Andy61994/SLAM_Bachelorarbeit_Pruefer/DataSheets/Pinout_Arduino_Mega.PNG

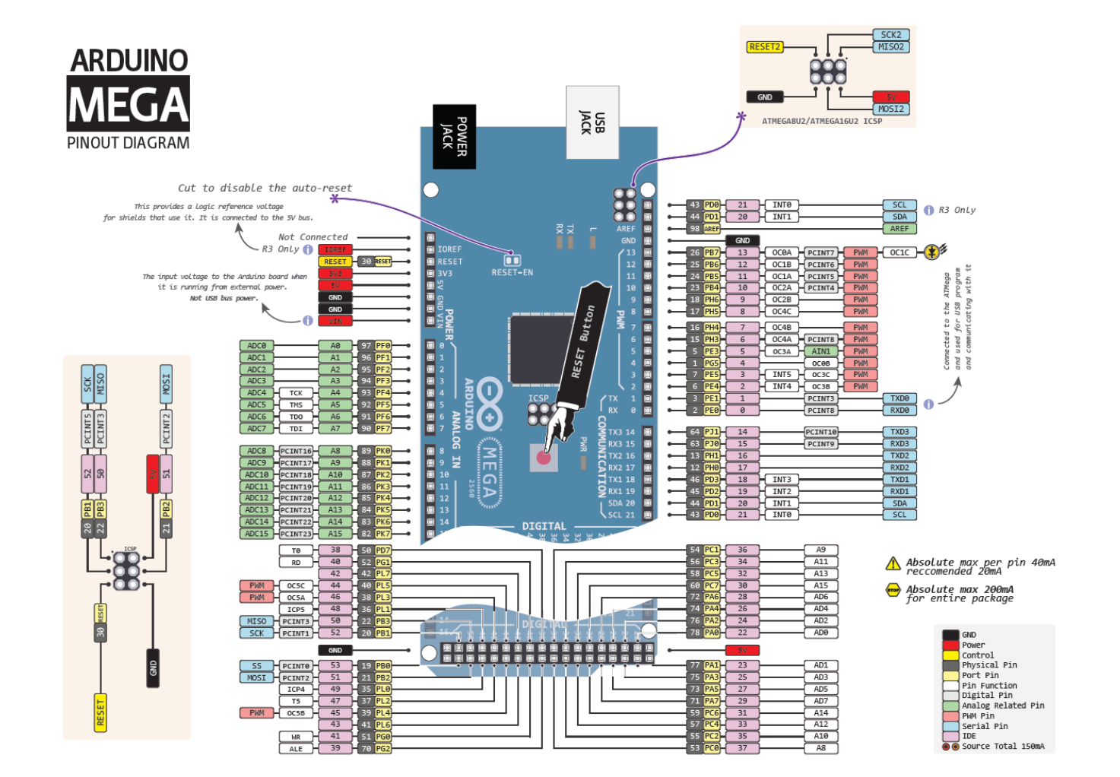
DataSheets/Pinout_Arduino_Mega.PNG
