Andy61994/SLAM_Bachelorarbeit_Pruefer/Digitaler_Anhang/CAD/IMG_20210322_150707.jpg

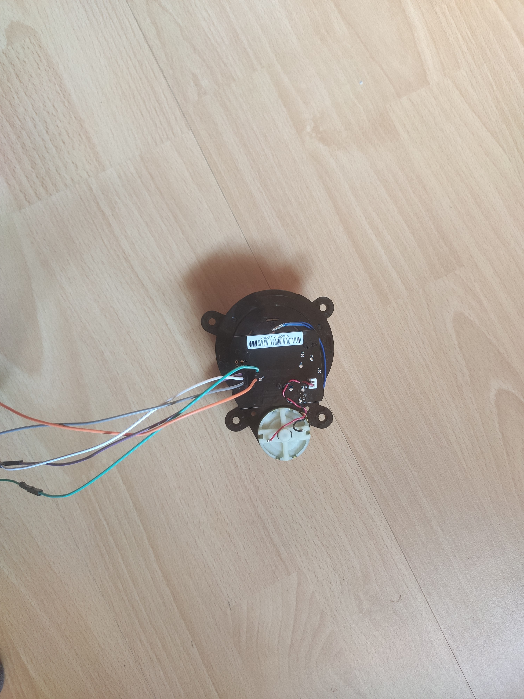
Digitaler_Anhang/CAD/IMG_20210322_150707.jpg
