Andy61994/SLAM_Bachelorarbeit_Pruefer/Digitaler_Anhang/Videos/mapping_filmed-YoutubeVideo.txt

https://www.youtube.com/watch?v=3mpuv1_3xI8&t=168s
