Andy61994/SLAM_Bachelorarbeit_Pruefer/Digitaler_Anhang/Bilder/D_A1_rosgraph_topics_and_nodes.png

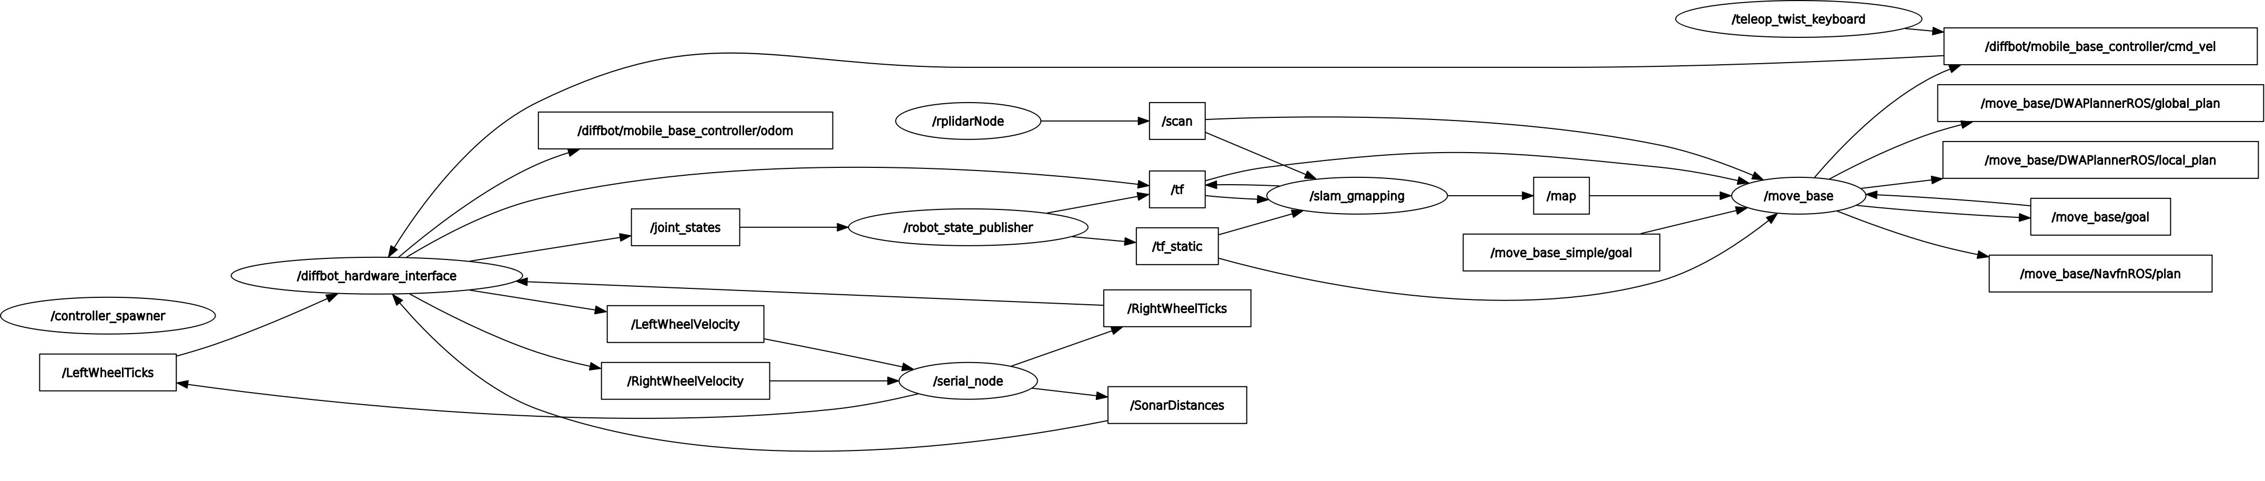
Digitaler_Anhang/Bilder/D_A1_rosgraph_topics_and_nodes.png
