Andy61994/SLAM_Bachelorarbeit_Pruefer/Digitaler_Anhang/Bilder/D_A3_tf_tree.png

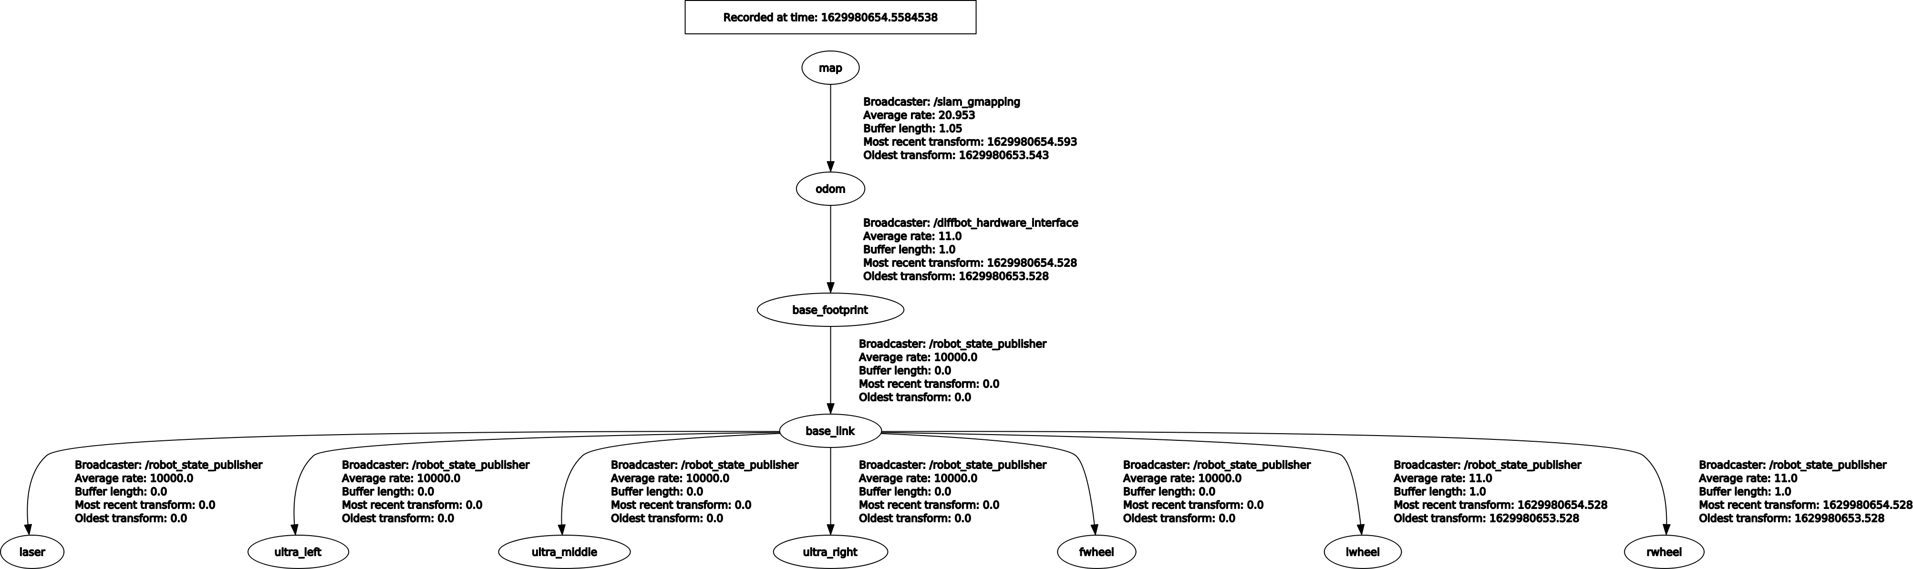
Digitaler_Anhang/Bilder/D_A3_tf_tree.png
