Andy61994/SLAM_Bachelorarbeit_Pruefer/Digitaler_Anhang/CAD/00_RobotAssembly.stl

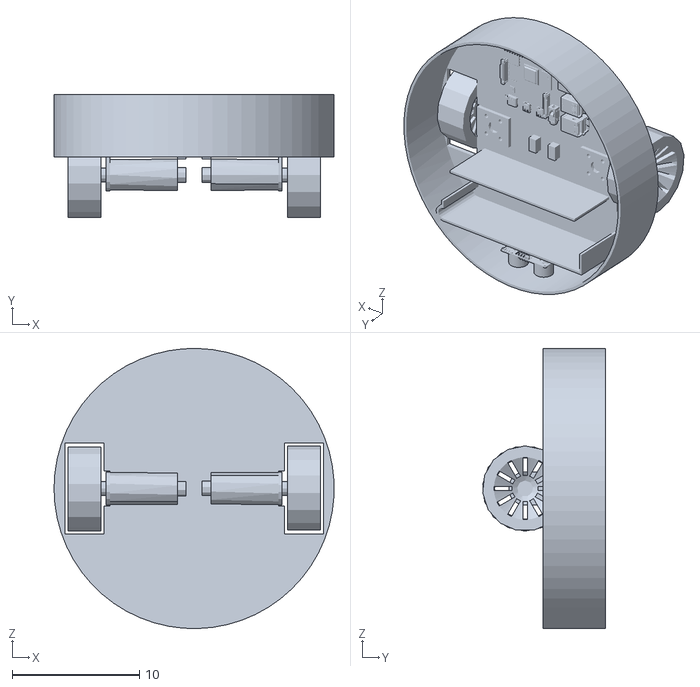
[picture p32: CAD file, 2021-09-02]
Digitaler_Anhang/CAD/00_RobotAssembly.stl
22.0 x 9.63 x 22.0
