Andy61994/SLAM_Bachelorarbeit_Pruefer/Digitaler_Anhang/CAD/ArduinoMega/Arduino Mega.STEP

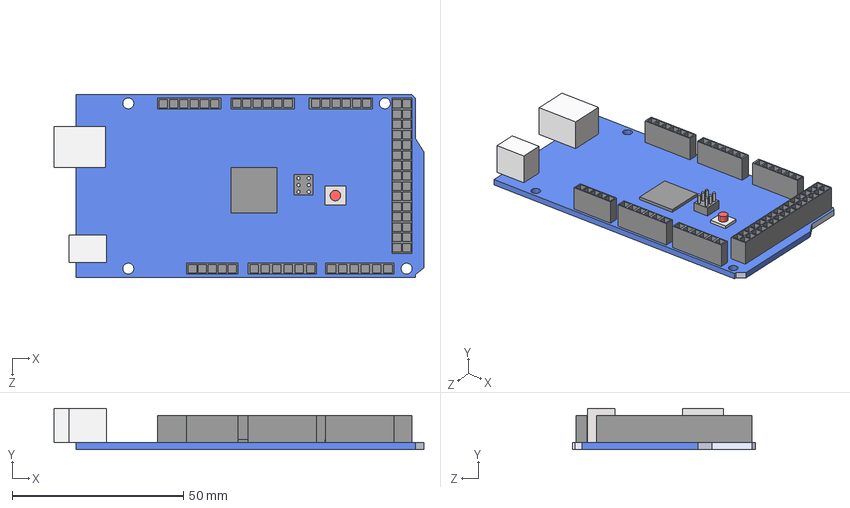
[picture p33: CAD file, 2021-09-02]
Digitaler_Anhang/CAD/ArduinoMega/Arduino Mega.STEP
108.1 x 12.0 x 53.3 mm
