Andy61994/SLAM_Bachelorarbeit_Pruefer/Digitaler_Anhang/CAD/Bauteil125.stl

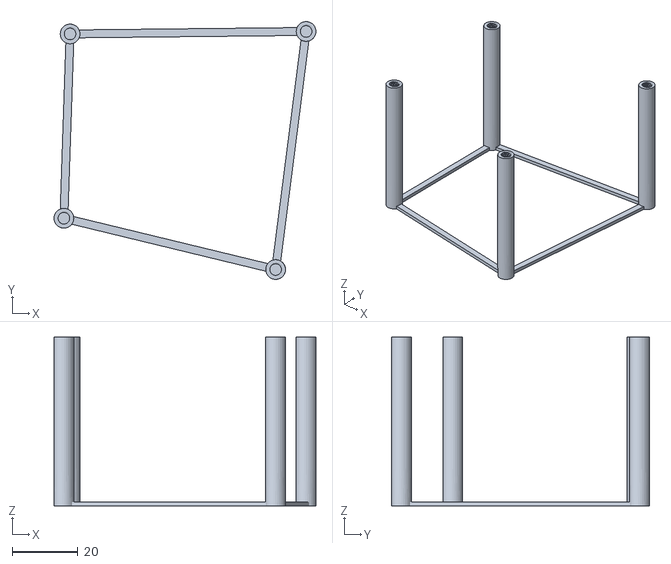
[picture p34: CAD file, 2021-09-02]
Digitaler_Anhang/CAD/Bauteil125.stl
79.5 x 78.2 x 51.2
