Andy61994/SLAM_Bachelorarbeit_Pruefer/Digitaler_Anhang/CAD/test/BauteilM_3_5.stl

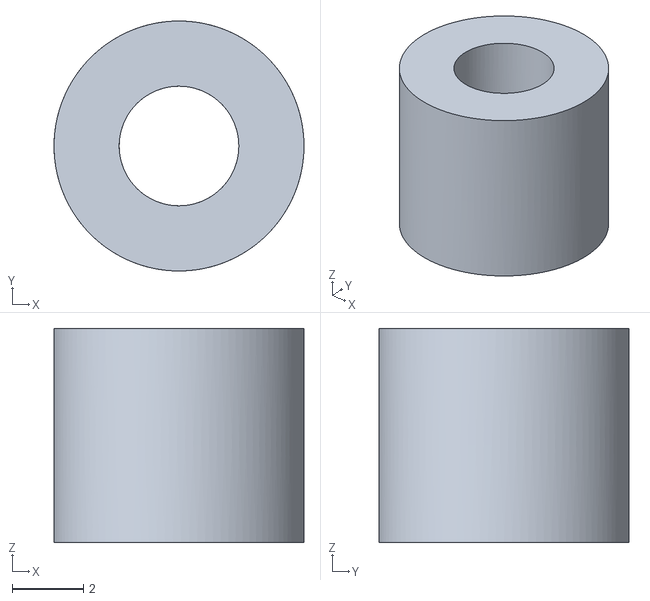
[picture p35: CAD file, 2021-09-02]
Digitaler_Anhang/CAD/test/BauteilM_3_5.stl
7.00 x 7.00 x 6.00
