Andy61994/SLAM_Bachelorarbeit_Pruefer/Digitaler_Anhang/CAD/08_HolderSR04.stl

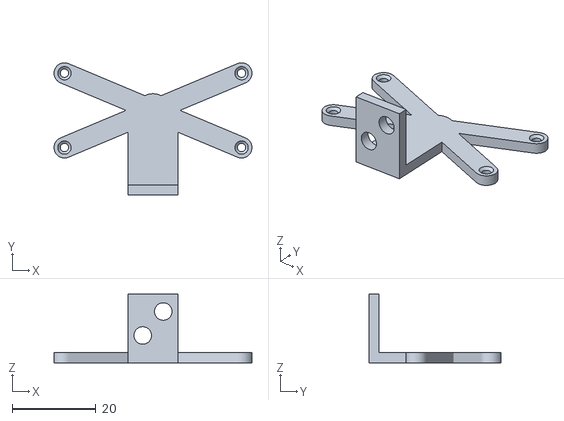
[picture p36: CAD file, 2021-09-02]
Digitaler_Anhang/CAD/08_HolderSR04.stl
47.4 x 31.7 x 16.4
