Andy61994/SLAM_Bachelorarbeit_Pruefer/Digitaler_Anhang/CAD/ArduinoMega/arduinoMegaSimplified.STEP

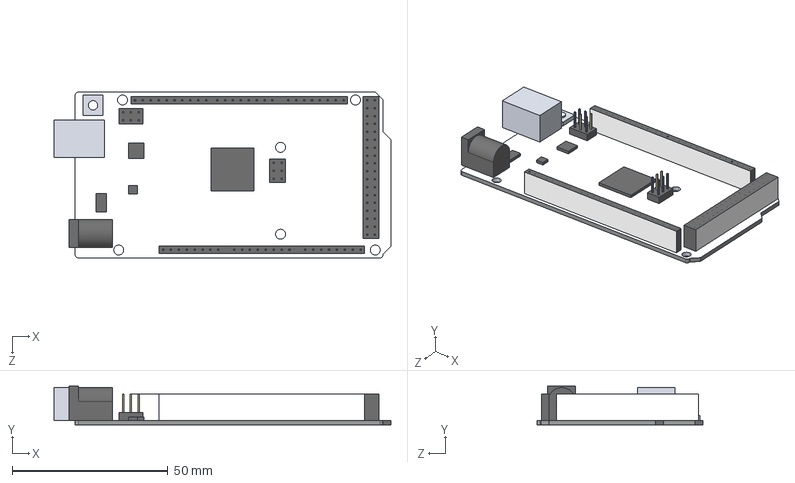
[picture p37: CAD file, 2021-09-02]
Digitaler_Anhang/CAD/ArduinoMega/arduinoMegaSimplified.STEP
108.3 x 12.5 x 53.3 mm
