Andy61994/SLAM_Bachelorarbeit_Pruefer/Digitaler_Anhang/CAD/test/Bauteil1.stl

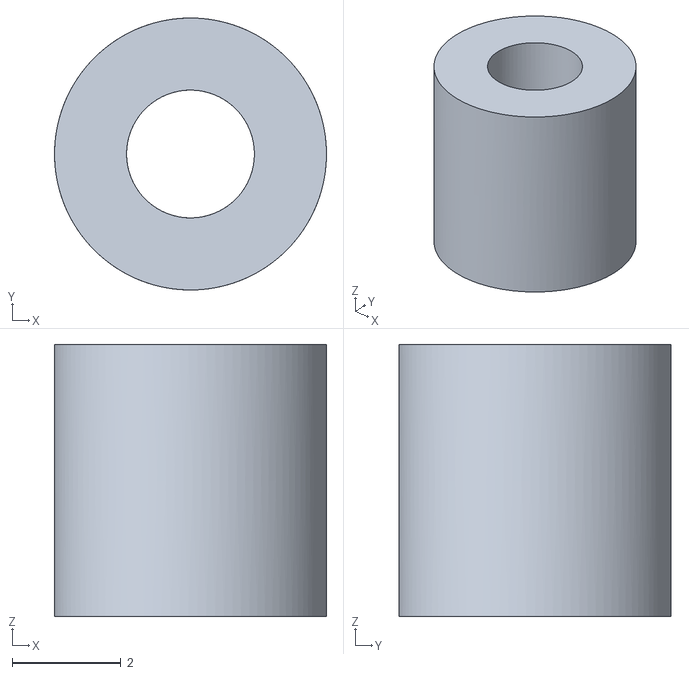
[picture p38: CAD file, 2021-09-02]
Digitaler_Anhang/CAD/test/Bauteil1.stl
5.00 x 5.00 x 5.00
