Andy61994/SLAM_Bachelorarbeit_Pruefer/Digitaler_Anhang/CAD/13_Motor_Fixation_Thread_Mount.stl

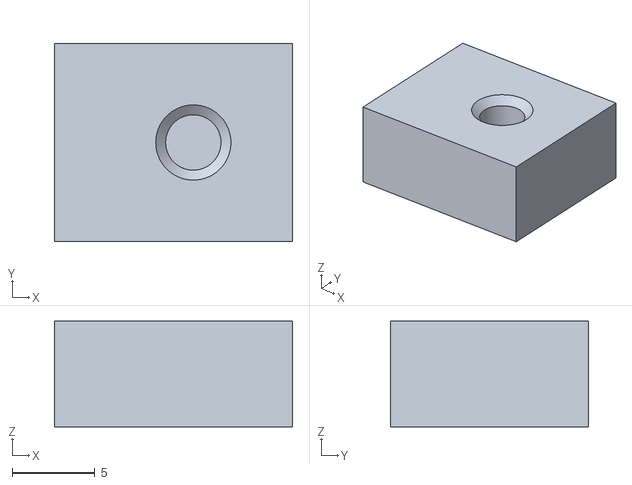
[picture p39: CAD file, 2021-09-02]
Digitaler_Anhang/CAD/13_Motor_Fixation_Thread_Mount.stl
14.4 x 12.0 x 6.40
