Andy61994/SLAM_Bachelorarbeit_Pruefer/Digitaler_Anhang/CAD/ArduinoMega/ArduinoMega_STEP_AP203.STEP

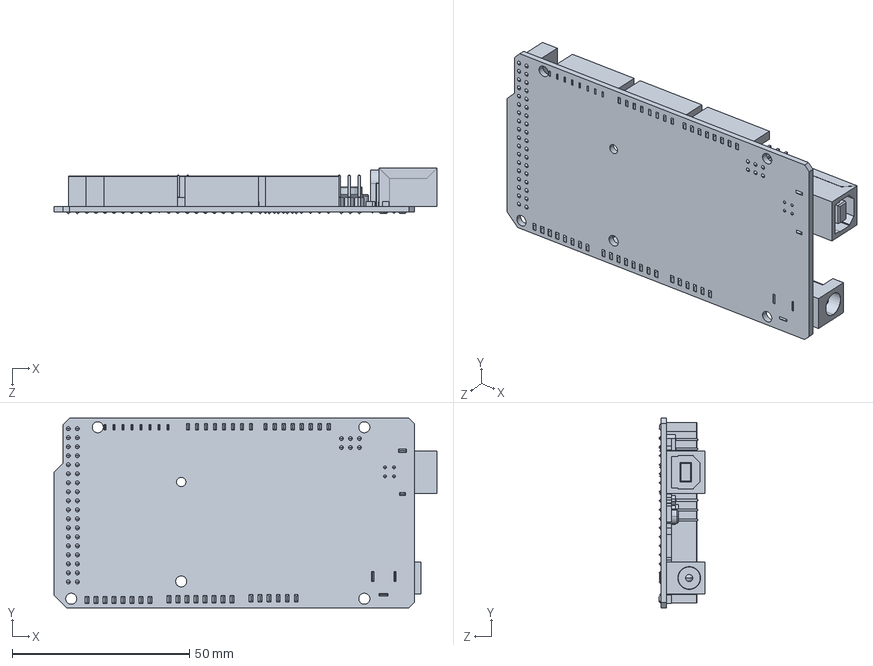
[picture p40: CAD file, 2021-09-02]
Digitaler_Anhang/CAD/ArduinoMega/ArduinoMega_STEP_AP203.STEP
107.9 x 53.4 x 13.0 mm
