Andy61994/SLAM_Bachelorarbeit_Pruefer/Digitaler_Anhang/CAD/11_Arduino_Holder.stl

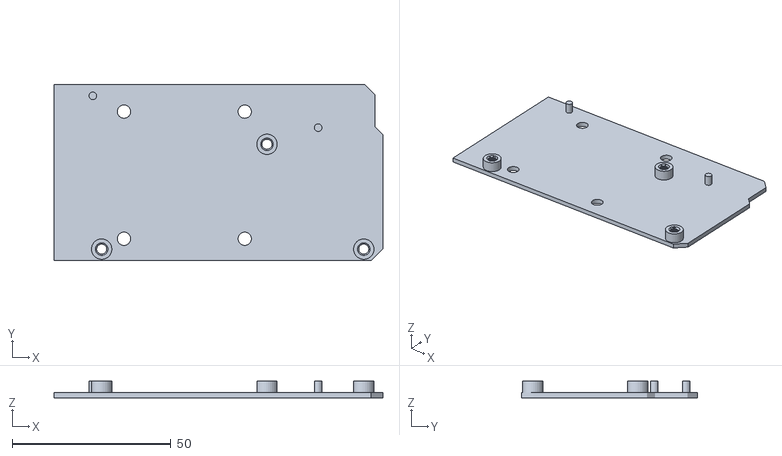
[picture p41: CAD file, 2021-09-02]
Digitaler_Anhang/CAD/11_Arduino_Holder.stl
103.5 x 55.3 x 5.20
