Andy61994/SLAM_Bachelorarbeit_Pruefer/Digitaler_Anhang/CAD/12_Motor_Fixation.stl

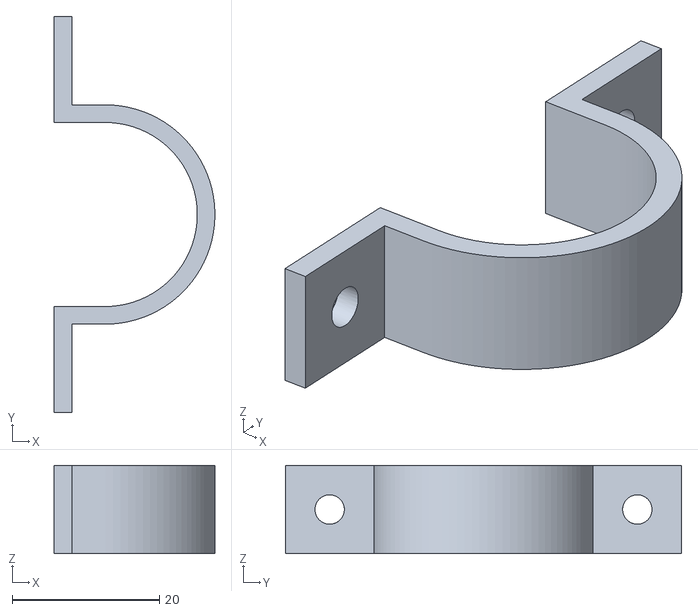
[picture p42: CAD file, 2021-09-02]
Digitaler_Anhang/CAD/12_Motor_Fixation.stl
21.8 x 53.8 x 12.0
