Andy61994/SLAM_Bachelorarbeit_Pruefer/Digitaler_Anhang/CAD/06_RPLidar_Raspi_Adabter.stl

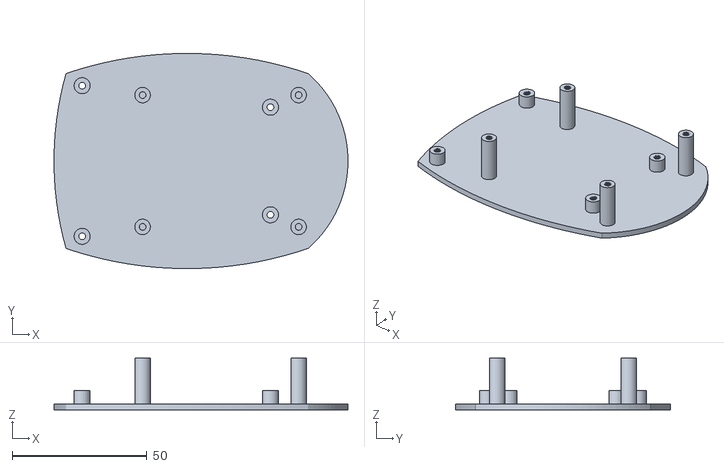
[picture p43: CAD file, 2021-09-02]
Digitaler_Anhang/CAD/06_RPLidar_Raspi_Adabter.stl
109.3 x 80.0 x 19.2
