Andy61994/SLAM_Bachelorarbeit_Pruefer/Digitaler_Anhang/CAD/10_Holder_Step_Down.stl

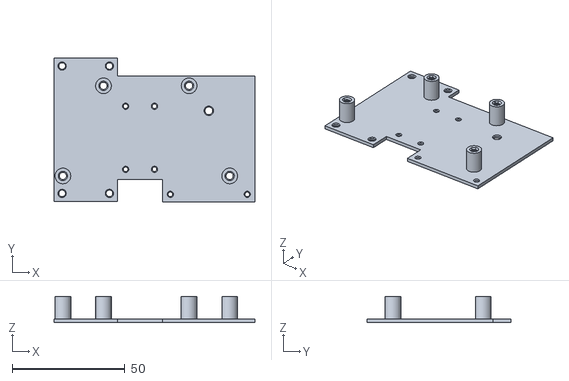
[picture p44: CAD file, 2021-09-02]
Digitaler_Anhang/CAD/10_Holder_Step_Down.stl
89.2 x 63.9 x 11.6
