Andy61994/SLAM_Bachelorarbeit_Pruefer/Digitaler_Anhang/CAD/03_MotorHolder.stl

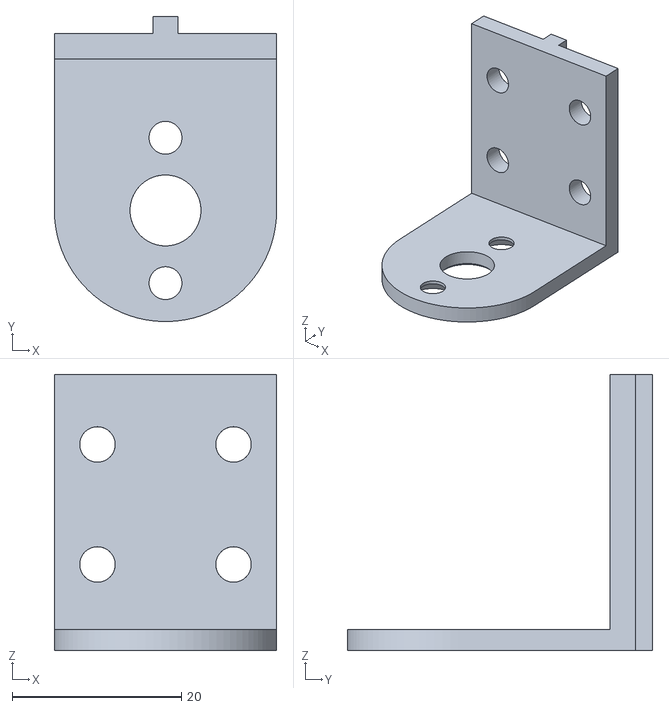
[picture p45: CAD file, 2021-09-02]
Digitaler_Anhang/CAD/03_MotorHolder.stl
26.3 x 36.1 x 32.7
