Andy61994/SLAM_Bachelorarbeit_Pruefer/Digitaler_Anhang/CAD/07_HolderSR04.stl

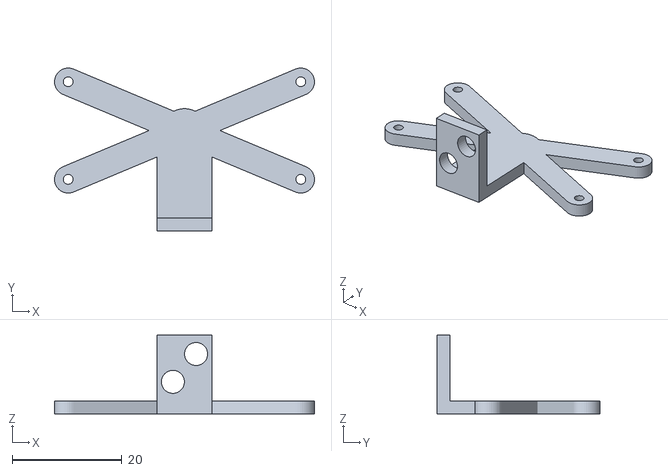
[picture p46: CAD file, 2021-09-02]
Digitaler_Anhang/CAD/07_HolderSR04.stl
47.4 x 29.7 x 14.4
