Andy61994/SLAM_Bachelorarbeit_Pruefer/Digitaler_Anhang/CAD/07_CaseTop.stl

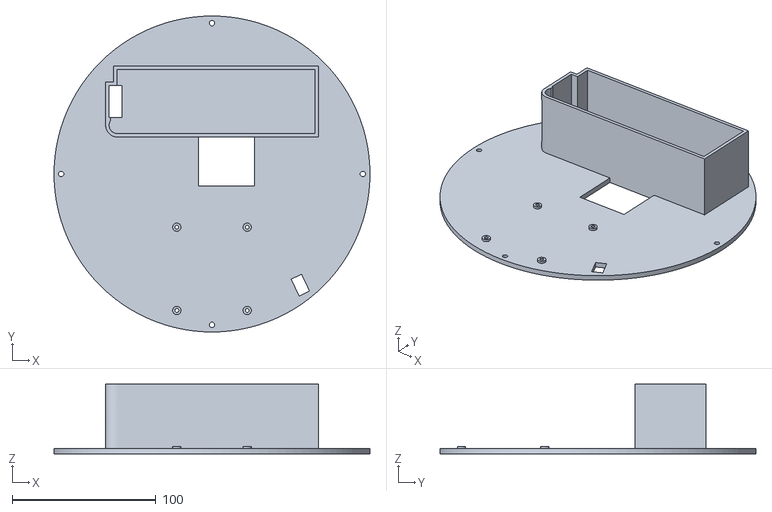
[picture p47: CAD file, 2021-09-02]
Digitaler_Anhang/CAD/07_CaseTop.stl
220.0 x 220.0 x 48.6
