Andy61994/SLAM_Bachelorarbeit_Pruefer/Digitaler_Anhang/CAD/06_RPLidar_Raspi_Adabter_NoThread.stl

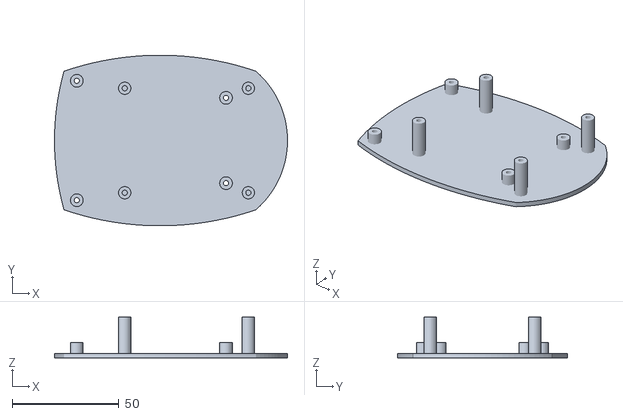
[picture p48: CAD file, 2021-09-02]
Digitaler_Anhang/CAD/06_RPLidar_Raspi_Adabter_NoThread.stl
109.3 x 80.0 x 19.2
