Andy61994/SLAM_Bachelorarbeit_Pruefer/Digitaler_Anhang/CAD/09_Cstor_Distance_Plate.stl

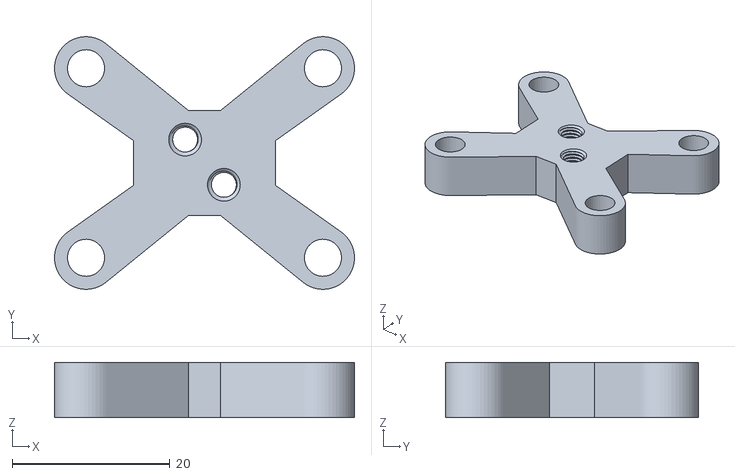
[picture p49: CAD file, 2021-09-02]
Digitaler_Anhang/CAD/09_Cstor_Distance_Plate.stl
38.0 x 32.0 x 7.00
