Andy61994/SLAM_Bachelorarbeit_Pruefer/(list of files, cad)

Other CAD files:
Digitaler_Anhang/CAD/test/Bauteil1_2.45.stl
Digitaler_Anhang/CAD/00_Mastersketch.ipt
Digitaler_Anhang/CAD/01_CaseBottom.ipt
Digitaler_Anhang/CAD/02_Motor.ipt
Digitaler_Anhang/CAD/03_MotorHolder.ipt
Digitaler_Anhang/CAD/04_Wheel.ipt
Digitaler_Anhang/CAD/05_WheelJoint.ipt
Digitaler_Anhang/CAD/06_RPLidar_Raspi_Adabter.ipt
Digitaler_Anhang/CAD/06_RPLidar_Raspi_Adabter_NoThread.ipt
Digitaler_Anhang/CAD/07_CaseTop.ipt
Digitaler_Anhang/CAD/08_HolderSR04.ipt
Digitaler_Anhang/CAD/09_Cstor_Distance_Plate.ipt
Digitaler_Anhang/CAD/10_Holder_Step_Down.ipt
Digitaler_Anhang/CAD/11_Arduino_Holder.ipt
Digitaler_Anhang/CAD/12_Motor_Fixation.ipt
Digitaler_Anhang/CAD/13_Motor_Fixation_Thread_Mount.ipt
Digitaler_Anhang/CAD/ArduinoMega/OldVersions/arduinoMegaSimplified.0001.ipt
Digitaler_Anhang/CAD/ArduinoMega/arduinoMegaSimplified.ipt
Digitaler_Anhang/CAD/Bauteil125.ipt
Digitaler_Anhang/CAD/CastorWheel/Castor_Wheel.ipt
Digitaler_Anhang/CAD/CastorWheel/OldVersions/Castor_Wheel.0001.ipt
Digitaler_Anhang/CAD/HC-SR04_Ultraronic/06_RPLidar_Raspi_Adabter_NoThread.ipt
Digitaler_Anhang/CAD/HC-SR04_Ultraronic/HC-SR04.ipt
Digitaler_Anhang/CAD/HC-SR04_Ultraronic/OldVersions/HC-SR04.0001.ipt
Digitaler_Anhang/CAD/HC-SR04_Ultraronic/OldVersions/HC-SR04.0002.ipt
Digitaler_Anhang/CAD/HC-SR04_Ultraronic/slam-head-rpi3-Powerbank-holder.ipt
Digitaler_Anhang/CAD/HC-SR04_Ultraronic/slam-head-rpi3-simple-Simple-Chassis_Full.ipt
Digitaler_Anhang/CAD/OldVersions/00_Mastersketch.0020.ipt
Digitaler_Anhang/CAD/OldVersions/01_CaseBottom.0029.ipt
Digitaler_Anhang/CAD/OldVersions/02_Motor.0005.ipt
Digitaler_Anhang/CAD/OldVersions/03_MotorHolder.0011.ipt
Digitaler_Anhang/CAD/OldVersions/04_Wheel.0005.ipt
Digitaler_Anhang/CAD/OldVersions/05_WheelJoint.0015.ipt
Digitaler_Anhang/CAD/OldVersions/06_RPLidar_Raspi_Adabter_NoThread.0001.ipt
Digitaler_Anhang/CAD/OldVersions/07_CaseTop.0009.ipt
Digitaler_Anhang/CAD/OldVersions/08_HolderSR04.0005.ipt
Digitaler_Anhang/CAD/OldVersions/09_Cstor_Distance_Plate.0005.ipt
Digitaler_Anhang/CAD/OldVersions/10_Holder_Step_Down.0004.ipt
Digitaler_Anhang/CAD/OldVersions/11_Arduino_Holder.0002.ipt
Digitaler_Anhang/CAD/OldVersions/12_Motor_Fixation.0005.ipt
Digitaler_Anhang/CAD/OldVersions/13_Motor_Fixation_Thread_Mount.0001.ipt
Digitaler_Anhang/CAD/OldVersions/13_Motor_Fixation_Thread_Mount.0004.ipt
Digitaler_Anhang/CAD/OldVersions/HolderSR04.0003.ipt
Digitaler_Anhang/CAD/RP-lidar-A1/OldVersions/RP-lidar-A1.0016.iam
Digitaler_Anhang/CAD/RP-lidar-A1/OldVersions/stand_15x2.0001.ipt
Digitaler_Anhang/CAD/RP-lidar-A1/RP-lidar-A1.iam
Digitaler_Anhang/CAD/RP-lidar-A1/Woodscrews_GB_TYPE136 M2X6-N.ipt
Digitaler_Anhang/CAD/RP-lidar-A1/base.ipt
Digitaler_Anhang/CAD/RP-lidar-A1/bottom-lid.ipt
Digitaler_Anhang/CAD/RP-lidar-A1/connector-1_25-3pin.ipt
Digitaler_Anhang/CAD/RP-lidar-A1/connector-1_25-4pin.ipt
Digitaler_Anhang/CAD/RP-lidar-A1/connector-7pin-2_5.ipt
Digitaler_Anhang/CAD/RP-lidar-A1/detector-mount.ipt
Digitaler_Anhang/CAD/RP-lidar-A1/detector.ipt
Digitaler_Anhang/CAD/RP-lidar-A1/devboard.ipt
Digitaler_Anhang/CAD/RP-lidar-A1/head-base.ipt
Digitaler_Anhang/CAD/RP-lidar-A1/head.ipt
Digitaler_Anhang/CAD/RP-lidar-A1/laser-mount.ipt
Digitaler_Anhang/CAD/RP-lidar-A1/laser.ipt
Digitaler_Anhang/CAD/RP-lidar-A1/motherboard.ipt
Digitaler_Anhang/CAD/RP-lidar-A1/motor-board.ipt
Digitaler_Anhang/CAD/RP-lidar-A1/motor.ipt
Digitaler_Anhang/CAD/RP-lidar-A1/rubber.ipt
Digitaler_Anhang/CAD/RP-lidar-A1/slam-head-rpi3-simple-Simple-Chassis_Full.ipt
Digitaler_Anhang/CAD/RP-lidar-A1/stand-8x2.ipt
Digitaler_Anhang/CAD/RP-lidar-A1/stand_15x2.ipt
Digitaler_Anhang/CAD/RP-lidar-A1/wheel.ipt
Digitaler_Anhang/CAD/RaspberryPi4B/2.54 mm DUPONT MALE PIN HEADER, IO, 2X20, RPi4ModelB.ipt
Digitaler_Anhang/CAD/RaspberryPi4B/2.54 mm DUPONT MALE PIN HEADER, POE, 2X2, RPi4ModelB.ipt
Digitaler_Anhang/CAD/RaspberryPi4B/2X USB2.0 PORTS, RPi4ModelB.ipt
Digitaler_Anhang/CAD/RaspberryPi4B/2X USB3.0 PORTS, RPi4ModelB.ipt
Digitaler_Anhang/CAD/RaspberryPi4B/91D77 D9WHV 778K, 4 GB LPDDR4 SDRAM, RPi4ModelB.ipt
Digitaler_Anhang/CAD/RaspberryPi4B/Broadcom BCM2711B0 CPU, RPi4ModelB.ipt
Digitaler_Anhang/CAD/RaspberryPi4B/Broadcom BCM54213PE Gigabit Ethernet Transceiver, RPi4ModelB.ipt
Digitaler_Anhang/CAD/RaspberryPi4B/Camera Connector, RPi4ModelB.ipt
Digitaler_Anhang/CAD/RaspberryPi4B/Cypress CYW43455 Wireless Module Cover, RPi4ModelB.ipt
Digitaler_Anhang/CAD/RaspberryPi4B/Display Connector, RPi4ModelB.ipt
Digitaler_Anhang/CAD/RaspberryPi4B/Female Micro HDMI Connector, RPi4ModelB.ipt
Digitaler_Anhang/CAD/RaspberryPi4B/Female USB Type C Connector, RPi4ModelB.ipt
Digitaler_Anhang/CAD/RaspberryPi4B/Gigabit Ethernet Port, RPi4ModelB.ipt
Digitaler_Anhang/CAD/RaspberryPi4B/Microphone Plug, RPi4ModelB.ipt
Digitaler_Anhang/CAD/RaspberryPi4B/MxL7704 Universal PMIC, RPi4ModelB.ipt
Digitaler_Anhang/CAD/RaspberryPi4B/PCB, RPi4ModelB.ipt
Digitaler_Anhang/CAD/RaspberryPi4B/Raspberry Pi 4 Model B.iam
Digitaler_Anhang/CAD/RaspberryPi4B/SD Card Slot, RPi4ModelB.ipt
Digitaler_Anhang/CAD/RaspberryPi4B/VIA VL805 PCIe USB 3.0 controller, RPi4ModelB.ipt
Digitaler_Anhang/CAD/Schrauben/Schraube_M2_5_Adapter.ipt
Digitaler_Anhang/CAD/StepDownConverter/PCB_PowerSupply.ipt
Digitaler_Anhang/CAD/StepDownConverter/Step_Down_USB.ipt
Digitaler_Anhang/CAD/test/Bauteil1.ipt
Digitaler_Anhang/CAD/test/BauteilM_3_5.ipt
Digitaler_Anhang/CAD/test/HolderSR04.ipt
Digitaler_Anhang/CAD/test/OldVersions/Bauteil1.0002.ipt
Digitaler_Anhang/CAD/test/OldVersions/BauteilM_3_5.0003.ipt
Digitaler_Anhang/CAD/test/OldVersions/HolderSR04.0001.ipt
