Andy61994/SLAM_Bachelorarbeit_Pruefer/Digitaler_Anhang/My_Diffbot_ROS_Packages/diffbot_control/config/control.yaml

diffbot:

    joints_update:
      type: "joint_state_controller/JointStateController"
      publish_rate: 50

    mobile_base_controller:
      type        : "diff_drive_controller/DiffDriveController"
      left_wheel  : 'left_wheel_joint'
      right_wheel : 'right_wheel_joint'
      publish_rate: 50.0               # default: 50
      pose_covariance_diagonal : [0.001, 0.001, 1000000.0, 1000000.0, 1000000.0, 1000.0]
      twist_covariance_diagonal: [0.001, 0.001, 1000000.0, 1000000.0, 1000000.0, 1000.0]

      # Wheel separation and diameter. These are both optional.
      # diff_drive_controller will attempt to read either one or both from the
      # URDF if not specified as a parameter
      wheel_separation : 0.170
      wheel_radius : 0.0335

      # Wheel separation and radius multipliers
      wheel_separation_multiplier: 1.0 # default: 1.0
      wheel_radius_multiplier    : 1.0 # default: 1.0

      # Velocity commands timeout [s], default 0.5
      cmd_vel_timeout: 0.5

      # Base frame_id
      base_frame_id: "base_footprint"

      # Velocity and acceleration limits
      # Whenever a min_* is unspecified, default to -max_*
      linear:
        x:
          has_velocity_limits    : true
          max_velocity           : 0.21  # m/s
          min_velocity           : -0.21 # m/s
          has_acceleration_limits: true
          max_acceleration       : 0.2  # m/s^2
          min_acceleration       : -0.2 # m/s^2
          has_jerk_limits        : true
          max_jerk               : 8  # m/s^3
      angular:
        z:
          has_velocity_limits    : true
          max_velocity           : 2.50  # rad/s
          has_acceleration_limits: true
          max_acceleration       : 2  # rad/s^2
          has_jerk_limits        : true
          max_jerk               : 4 # rad/s^3
